skiphansen/panog2_sdcard/assets/top.png

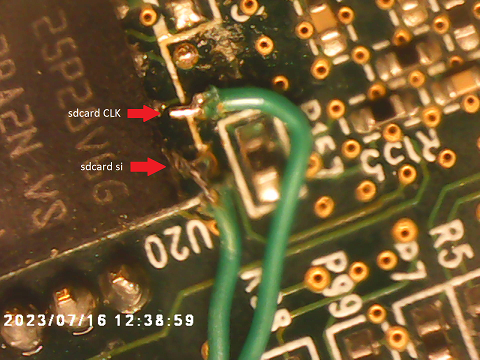
assets/top.png
