skiphansen/panog2_sdcard/assets/wire_exit.png

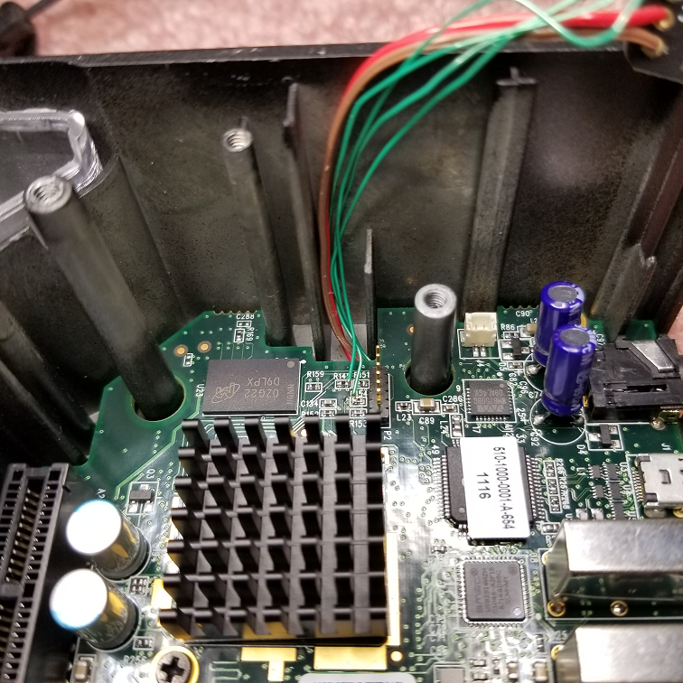
assets/wire_exit.png
