skiphansen/panog2_sdcard/(commit log)

2023-07-04 WIP - added support for using spi_lite RTL instead of bit banging. Working, current SPI clock is 10 Mhz.
2023-07-04 Increased SPI clock to 20 Mhz (C_SCK_RATIO = 0 -> /2).
2023-07-17 Changed SD card connections to SPI flash pins. Updated the documentation.
